zoetangprometheus-dotcom/cyber-turtle-clawhunt/archive/project-documents/GitHub协作交接-2026-10-31.md

# GitHub 协作交接

- 日期：2026-10-31
- 公开仓库：https://github.com/zoetangprometheus-dotcom/cyber-turtle-clawhunt
- 默认分支：main
- 首次提交：66b36433514e1e6f92406a8c0f54c0e03428513d
- 本地工作副本：本目录下 `cyber-turtle-clawhunt/`
- 后端入口：`cyber-turtle-clawhunt/docs/BACKEND_AGENT.md`
- 协作规范：`cyber-turtle-clawhunt/AGENTS.md`
- 提示词：`cyber-turtle-clawhunt/docs/AI_CONTENT.md`

## 后续维护

后续代码、接口和内容修改以 `cyber-turtle-clawhunt/` 为共享代码源，创建分支并通过 PR 合并。原 `A-前端与内容/整体框架-v0.1/` 保留为发布前的本地阶段稿，不与共享仓库自动双向同步。旧项目规划材料仍留在原目录，本次未整体公开 Obsidian 项目资料。

仓库的内容源为 data/content-examples.json 和 data/hexagrams.json；运行 scripts/refresh-demo-data.py 同步 h5/data.js。模型文字 schema 位于 schemas/ai-output-schemas.json。前端代码、样式、交互保持原版本。

用户自行邀请队友；本次未邀请、未授予他人写权限，未配置分支保护，未公开部署网站。GitHub 公开代码与网站上线是不同状态。原创代码许可证尚未选定，第三方 CC0 数据保留来源、许可与校验快照。

## 验收结果

- node tests/history.test.cjs：通过。
- python3 tests/check-data.py：通过；仅结构校验，文化审核尚未完成。
- node --check h5/app.js 与 h5/history.js：通过。
- 数据重新生成后与原 h5/data.js 逐字节一致。
- 内容样例字段、长度和非空规则检查通过，上游原始快照 SHA-256 一致。
- 待发布文件的常见凭据格式与本机私人路径扫描未命中；未上传用户历史记录、密钥或整个 Vault。
- 匿名 GitHub API 和 raw 文件读取成功，确认 PUBLIC、main 及首个提交；24 个远端 blob 与本地内容一致，本地工作区干净。

真实 AI、QR 领取、服务器会话、热敏设备与真实手机浏览器仍待 B 联调，详见后端 README。
