zoetangprometheus-dotcom/cyber-turtle-clawhunt/archive/project-documents/赛博龟壳_产品定位_PRD_三人分工_v3.1.md

# 赛博龟壳 Cyber Turtle｜产品定位、PRD 与三人分工

> **版本**：v3.1（讨论稿）  
> **日期**：2026-10-30  
> **用途**：黑客松商业化产品赛道；供三人团队统一产品定义、界定开发范围、对齐交付接口。  
> **状态**：本文为拟议产品规范，非已实现功能说明。具体芯片型号、屏幕尺寸、打印机、成本、比赛时长及效果指标仍需实测确认。  
> **资料基础**：《赛博龟壳｜黑客松项目规划 v1.0》及后续产品讨论。以本版用户确认的决策覆盖旧版的出生信息、八字排盘、NFC 前置绑定、纸条二维码和摇前主题选择流程。

---

## 0. 一页概要（Executive Summary）

**一句话定位**：一款以东方八卦与六十四卦文化为灵感、采用 ESP32 驱动的手持式桌面互动占卜潮玩，通过摇动起卦、龟甲纹路依次点亮、AI 趣味解读及实体签文打印，创造类似塔罗但具有东方器物美学的仪式体验；用户可在打印结束后扫码获得进一步的主题化 AI 深度解读、数字收藏和分享。

**英文版本**：*An AI-powered physical divination collectible inspired by the I Ching—shake to reveal a hexagram, receive a printed fortune, and optionally scan for a deeper reading and digital keepsake.*

**产品主张**：**遇事不决，摇壳问问。** / *A little fortune, made tangible.*

**必须守住的体验原则**：
1. **不强制手机**：摇动、亮卦、基础解读、打印必须独立完成。
2. **先实体，后数字**：先出签；感兴趣的用户才扫描设备屏幕上的动态二维码，选择主题并获得一次新的、基于原卦的深度解读。
3. **一卦一记录**：纸质基础签与后续电子深度解读属于同一个卦象记录；深度解读不重新起卦。
4. **八卦作可视语言，六十四卦作内容基础**：先后点亮上卦和下卦，纸张上印完整六爻本卦。
5. **古典东方器物优先**：关机/待机时应像可收藏的古典器物，而非通用电子小玩具；光效、屏幕和出纸口服从整体器物语言。
6. **可解释但不神化**：卦象由规则化随机机制确定，AI 做文学化、娱乐化解读，不承诺预测准确性，也不替用户作医疗、投资等重大决定。

**本轮关键变更**：

| 原方案/之前讨论 | 本版确定方向 |
|---|---|
| 首次填写出生年月日 / 八字计算 | **取消**。无个人资料输入；采用八卦视觉和六十四卦内容体系 |
| 手机在起卦前选主题 | **取消前置选题**。默认实体今日签；扫码后才选主题并触发**二次 AI 深度解读** |
| NFC 碰设备再收藏 | **取消作为本版默认路径**；改为 ESP32 中央小屏显示动态二维码 |
| 在签文纸条上印二维码 | **不印**；二维码**仅显示在设备屏幕上**，并在打印完成后出现 |
| 八卦一次性亮起 | **先后点亮上卦、下卦**；最终在纸条呈现完整六爻卦象 |
| 现代赛博玩具外观 | **偏古典东方器物**，以灯光和隐藏式显示实现“古典外观 × 数字内核” |
| 原规划五个技术模块分工 | **三人主责**：①前端/平面/内容生成体验，②硬件/嵌入式/后端，③实体外壳/工业设计 |

---

## 1. 产品定位与市场假设

### 1.1 类别与用户价值

- **品类**：东方文化启发的互动占卜潮玩（Interactive Divination Collectible / Physical Ritual Toy）。
- **体验对标**：塔罗的象征解读、随机惊喜、自我探索与社交话题；**不是**传统塔罗牌的电子替代，也不是以预测准确率作为卖点的算命服务。
- **核心体验**：摇动器物 → 看见卦象显现 → 得到一张真实纸签 → 可选择进一步解读及数字保存。
- **价值主张**：仪式感、惊喜、趣味自我探索、可触摸的纪念以及礼物属性。
- **核心购买场景**：个人桌面收藏与日常趣味使用；创意礼品与朋友/情侣赠礼。**两者暂不排序，首轮测试比较。**

### 1.2 目标用户（待市场验证的细分定义）

| 细分 | 典型特征 | 核心动机 | 验证重点 |
|---|---|---|---|
| A. 轻玄学与自我探索爱好者（主要使用人群） | 建议首批测试 18–30 岁，关注塔罗、星座、易经或情绪仪式，不一定相信其预测能力 | 想获得独特的解读、未知感和心理仪式 | 相比免费 App 是否更愿意使用或购买实体设备 |
| B. 设计潮玩/东方美学收藏者 | 喜欢器物美学、桌面摆件、创意电子产品 | 造型、触感、收藏性 | 不使用功能时是否仍愿意摆放和购买 |
| C. 赠礼购买者 | 给伴侣、朋友或同事挑选新奇礼物 | 赠礼寓意、开箱体验、现场互动 | 送礼意愿、价格带、包装重视度 |
| D. 关系互动用户（未来） | 情侣与朋友 | 双人关系趣味解读和社交破冰 | 是否愿意为了双龟功能购买第二台 |

> 年龄、价格与购买意愿均为**研究假设**，不要在商业 Pitch 中写成已证实的市场事实。

### 1.3 商业逻辑（假设，非收入承诺）

- **首要收入**：B2C 实体设备销售，强调器物外观、娱乐价值及赠礼属性。
- **后续可选**：限定外观/节日礼盒、主题卡面或扩展内容、B2B 活动定制；不建议首版将基础扫码保存强行收费。
- **商业验证**：个人自用与赠礼用户分别询价；收集有价格提示的购买意向，优先考察真实预订/定金等行为，而非仅询问“喜不喜欢”。
- **潜在壁垒**：品牌视觉、器物设计、稳定的完整仪式、内容品质与用户体验；**不把通用 AI API、普通 ESP32 连接或热敏打印称为专利级技术创新**。

---

## 2. PRD：用户旅程与需求

### 2.1 用户场景

**场景 A｜无需手机的默认今日签**
1. 设备处于待机，中央小屏展示品牌 Logo；表面八卦纹路不常亮或仅有很弱的待机灯。
2. 用户拿起龟壳摇动，设备通过运动传感器识别有效动作并防抖去重。
3. 设备先后展示**上卦、下卦**的灯光序列；其组合对应一个**六十四卦本卦**。
4. 云端/后端以固定卦象含义为基础生成**简短基础今日签**，检查结构、长度和安全性。
5. 等待设备稳定后打印纸质签文，纸上有**完整六爻卦形**、卦名、趣味解读和一句小行动；**纸条无二维码**。
6. **打印完成**后，中央小屏由流程状态切换到**本次专属动态二维码**，出现扫码提示及倒计时。
7. 用户可以无视二维码，直接取签结束；到时自动回到 Logo 待机。

**场景 B｜扫码后选择主题并得到深度解读**
1. 在打印完成后的有效时间内，用户扫描设备小屏的动态二维码，打开移动端 H5（无需安装 App）。
2. H5 先展示本次的**固定卦象和基础签文**，让用户确认与纸条对应。
3. 用户可选择**今日/自我、感情、事业/学业、友情**等主题；可直接选择“保存基础签文”，不被迫使用 AI 深度解读。
4. 选定主题后点击“深入解读”，后端基于**同一卦象**、原基础签文、所选主题，进行**第二次 AI 生成**。不重新随机起卦，不覆盖原纸签文字。
5. 页面呈现结构化的扩展解读（例如「卦象含义」「对当前主题的启发」「一个可尝试的小行动」）。
6. 用户可保存为图片或使用系统分享；历史收藏、账号云同步可延后。

**场景 C｜未扫码或二维码过期**
- 不影响已经完成的实体占卜及纸签。
- 过期二维码显示“本次扫码已结束”，再切回 Logo。
- 为避免错配，下次起卦后生成**新的**二维码；过期链接不能自动跳转到“上一位用户的最近签文”。

### 2.2 二维码时效：明确建议

**默认建议：二维码在屏幕上显示 180 秒（3 分钟），且扫码访问令牌在生成后 180 秒过期。**

这是初版产品的**设计建议**，不是平台技术硬性限制。理由：在出纸、拿手机、解锁、启动相机和完成扫描之间留有实际操作余量；同时缩短旁观者在公共/共享设备环境中扫描他人结果的窗口。**建议通过 5–10 人的真实扫码测试再校正为 120–300 秒。**

- **起计点**：以后端确认生成了签文记录、设备反馈打印成功（或以传感器/固件可确认的“打印任务结束”代替）后开始。不能把“命令已发送”冒充“纸张已成功输出”。
- **屏幕显示**：二维码 + “扫码查看/收藏” + 简易剩余时间（如 `02:59`）。到时回 Logo。
- **服务端校验**：短时、高熵、不可预测的随机访问令牌；服务端验证到期时间、记录 ID 和状态；不要只在客户端做倒计时。
- **成功扫码后**：在 180 秒内完成**首次打开页面**即可将会话转成独立的网页会话（建议有效 30 分钟，供选择主题和生成解读）；避免用户刚打开页面、读到一半就失效。网页会话时长也属建议值，可调整。二维码本身仍到期失效。
- **重复扫码**：过期前允许同一 URL 多次打开基础内容；若要限定只有本人可进一步操作，需加入一次性领取或会话占用机制。比赛版建议**首个成功领取的浏览器获得 30 分钟编辑会话**，其他访问者只显示“本次签文已领取/已过期”，避免他人选择主题或拿走分享权限。需要允许合法用户刷新页面（靠短时会话 Cookie/安全令牌实现），而不是每次刷新都重新认领。
- **扫码不及**：本次版本不强制提供“重开上一次二维码”按钮，避免共享设备上误公开上一人内容。以后如加恢复入口，必须设计物理确认及新的短时令牌，且只对当前记录有效。
- **已保存内容**：二维码时效**不等于**收藏时效；用户已打开并保存的图片可长期留在手机，云端留存时长另行约定。
- **下一人摇动**：若上次二维码还在屏上，新一次有效起卦应先终止上一二维码展示并撤销**未领取的**入口，避免扫码读到别人的内容；已领取的网页会话保留自己的签文记录，不被新一签覆盖。

**二维码内容**：短域名下的 HTTPS 链接 + 随机短期访问令牌，例如 `https://<domain>/r/<opaque-token>`（占位格式，非真实可用网址）。二维码编码的是**短 URL**，不直接写明签文、私人提问、连续编号或密钥。

**与 ESP32 屏幕有关的技术条件**：屏幕**具体尺寸/分辨率、显示技术、可视角度、亮度**尚未确认；应实测相机可读性。短 URL、适当二维码版本、足够的像素块宽与白边，比复杂装饰更重要。待机 Logo 可精致，但二维码显示需高对比、无动画遮挡。

### 2.3 占卜生成规则与 AI 边界

- **卦象计算**：两个三爻卦依次选择，上卦与下卦映射为一个确定的六爻本卦（共 64 种）。为每卦建立：上下卦、六爻表示、卦名、解释关键词、固定基础含义。**不要用 AI 直接编造卦名或爻序**。
- **点亮**：一次摇动触发两段灯光。先点亮上卦位置/序列，熄减后再点亮下卦位置/序列；最后纸张上以六条线完整展现本卦。表面八卦排列采用什么传统方位/排列规则，需产品/视觉共同确认；不能任意混用先天与后天八卦的符号布局。
- **随机性**：当前为娱乐随机抽取，不声称测量命运；决定卦象的规则透明可复现，保留测试随机种子/调试模式但不向普通用户显示。
- **基础签文生成 #1**：输入卦象规范数据和默认“今日签”语境；输出短标题、一段趣味提示、一条小行动；经结构校验后固定写入记录。
- **深度解读生成 #2**：用户扫码后自行选主题，才发起第二次 AI 调用；输入**同一卦象 + 所选主题 + 基础签文**，输出结构化内容；不改变本卦及已打印的内容。
- **主题选项**：今日/自我、感情、事业/学业、友情。个性化自由输入不是本版必需；如后续开放文本提问，增加隐私、敏感内容与提示注入防护。
- **内容调性**：温暖、幽默、带适度神秘感，但不全是正能量套话；允许中性提醒，不使用“必然/注定/百分百”等绝对预测。
- **安全性**：娱乐与自我探索，不提供诊断、财富保证、危机处理替代建议，避免对现实重大决定作命令式判断。

### 2.4 功能需求（FR）

| ID | 功能 | 要求/验收口径 | 优先级 |
|---|---|---|---|
| FR-01 | Logo 待机 | 上电显示 Logo；无求签时稳定显示；亮度可调 | P0 |
| FR-02 | 摇动触发 | 正常拿取不易误触发；一次有效摇动只创建一个任务 | P0 |
| FR-03 | 六十四卦规则 | 上下卦组合、卦名与六爻图样一一对应，测试覆盖 64 组合 | P0 |
| FR-04 | 分阶段光效 | 先上卦后下卦，灯光表达与实际本卦一致 | P0（简化光效也需真实） |
| FR-05 | AI 基础签文 | 合规、结构化、可打印、长度受控；断网处理有路径 | P0 |
| FR-06 | 热敏打印 | 真正打印且包含完整卦符；不含二维码；不乱码不截断 | P0 |
| FR-07 | 动态二维码 | 仅在**打印完成后**的小屏显示本次二维码；默认 180 秒 | P0 |
| FR-08 | H5 基础详情 | 扫码看到与纸条对应的卦象/基础签文，不能错配 | P0 |
| FR-09 | 扫码后选主题 | 不需要摇前网页；在数字页选择主题并主动触发深度解读 | P0 |
| FR-10 | AI 深度解读 | 基于同一卦象+选定主题进行第二次生成；状态与失败可恢复 | P0 |
| FR-11 | 保存与分享 | 至少支持保存图片或复制分享内容，明确操作反馈 | P0 |
| FR-12 | 错误/超时 | 网络断开、模型超时、缺纸、二维码到期有明确反馈 | P0 |
| FR-13 | 历史收藏册 | 多日历史、云同步、账户体系 | P2 |
| FR-14 | 双龟社交 | 碰一碰 → 双人关系趣味解读；需独立通信与隐私设计 | Future |
| FR-15 | NFC 扫描 | 本版不作为必需功能，保留未来可能性 | Future |

> 如果比赛时间非常紧，优先保证 **FR-01～FR-08** 的端到端真机演示；FR-09～FR-11 至少制作一条可真实调用的网页路径，不可把静态假界面冒充已实现 AI 深度解读。

### 2.5 非功能需求（NFR）与建议验收

| 项目 | 建议目标（须实测） |
|---|---|
| 稳定性 | 至少 10 次连续完整求签，记录成功/失败、耗时和失败原因 |
| 可理解性 | 至少 5 名陌生测试者不经详细解释，能够摇出签；其中多数能理解扫码是可选的 |
| 扫码成功率 | 不同手机在常见室内光照下实测，建议至少 9/10 次一次扫描成功 |
| 打印 | 中文清晰，六爻图样准确；无严重歪斜、乱码或切纸异常 |
| 隐私 | 不收集出生信息；二维码 URL 不包含用户明文数据；服务端日志不记录完整敏感提问 |
| 安全 | 设备可握持、无明显烫手/锐角/裸露导线；打印时停止摇动检测，保护机构 |
| 电源 | 保证打印机峰值功率；避免灯光、屏幕与打印同时工作导致掉电重启 |
| 性能 | 记录从停止摇动到打印完成的 P50/P90 时间；暂不虚构指标，在测得后填入 Pitch |
| 容错 | 模型调用/打印失败不产生重复打印；任务有唯一 ID 和可重试状态 |

### 2.6 设备状态机

```text
POWER_ON → IDLE_LOGO
IDLE_LOGO --有效摇动--> SHAKE_DETECTED → HEXAGRAM_REVEAL_TOP → HEXAGRAM_REVEAL_BOTTOM
→ AI_BASE_GENERATING → PRINTING → PRINT_FINISHED → QR_ACTIVE (180s) → IDLE_LOGO

AI_BASE_GENERATING / PRINTING --失败--> ERROR（显示原因/重试或离线备用）
QR_ACTIVE --扫码领取--> 网页会话开启；设备继续显示至超时或新请求
QR_ACTIVE --新一签开始--> 关闭旧未领取二维码 → 新流程
```

- 原则：**只能确认打印完成后显示二维码**；若采用无状态反馈的打印模组，须在演示时明确完成条件是假设性时序，并增加超时与失败指示，不能虚称已检测到纸张成功输出。
- 建议通过一枚隐藏式物理按钮提供**取消/复位**，不是交互主入口；是否需要重新打印同一张签由硬件可靠性测试后决定。

### 2.7 数据模型与接口契约（建议）

**核心实体**：

```json
{
  "reading_id": "uuid",
  "device_id": "opaque-device-id",
  "created_at": "timestamp",
  "upper_trigram": "canonical-trigram-id",
  "lower_trigram": "canonical-trigram-id",
  "hexagram_id": 1,
  "hexagram_name": "canonical-name",
  "hexagram_lines": [1,1,1,1,1,1],
  "base_reading": {"title":"...", "message":"...", "action":"..."},
  "print_status": "pending|printing|completed|failed",
  "qr_status": "inactive|active|claimed|expired|revoked",
  "qr_expires_at": "timestamp",
  "deep_reading": {"theme":"friendship", "content":null}
}
```

> 上述 `hexagram_lines` 是**数据结构例子**，不代表示例卦序映射已被审核；实际采用明确的上下/自下而上索引规范，并建立全量单元测试。

**推荐接口边界**：

| API / 事件 | 触发方 → 负责方 | 用途 |
|---|---|---|
| `POST /device/readings` | ESP32 → 后端 | 创建唯一求签任务，提交设备 ID、事件 ID 与卦象（或请求服务器确定卦象，二选一并锁定规范） |
| `GET /device/readings/{id}/status` | ESP32 → 后端 | 获得生成状态、打印内容和二维码令牌（可轮询或长连接） |
| `POST /device/readings/{id}/print-complete` | ESP32 → 后端 | 上报打印任务完成，才启动 QR 时效 |
| `GET /r/{token}` | 用户浏览器 → 后端/H5 | 验证短时令牌并领取页面会话，显示原始签文 |
| `POST /readings/{id}/deep-reading` | H5 → 后端 | 提交主题，触发第二次 AI 解读；权限由会话验证 |
| `GET /readings/{id}/deep-reading` | H5 → 后端 | 查询生成状态与结果 |
| `GET /readings/{id}/share` / 客户端导出 | H5 → 前端/后端 | 生成可保存图片或分享内容 |

**API 协议原则**：
- 设备认证密钥与模型 API Key **只在后端安全存储**，不写入网页代码或公开仓库。
- 每次摇动拥有唯一事件 ID，实现幂等性，重试不重复生成或打印。
- 后端保存卦象与基础签文的不可变快照；深度解读只增加附属记录。
- 设备二维码链接与用户 Web 会话应独立，不把一次性扫码 token 永久当用户身份凭据。
- 原型开发如为减少范围使用简化身份体系，也需标记为 Demo，不以其安全性满足商业量产要求。

---

## 3. 视觉与工业设计规范

### 3.1 外观定位：古典东方器物

**方向关键词**：龟甲、卜筮器、温润、含蓄、克制、留白、光从纹路中浮现。

- 休眠时是一件值得摆放的器物：隐藏 LED 和屏幕的数码感，不以炫光/赛博朋克为主。
- 外形首先满足**握持摇动的平衡、重量、表面触感**，其次再追求龟壳形体精致度。
- **屏幕位于产品中央**，待机显示 Logo；打印后展示扫码二维码。应将它视为器物的“印记/铭牌/核心窗口”，而非突兀手机小屏。
- 八卦纹路既是视觉主题，也是起卦光效的真实反馈层。可尝试半透光壳体、内嵌导光结构、扩散片。
- 以古铜、陶、玉石感、木质调等作为**材质语言参考**，原型可以采用可加工的塑料/树脂表面处理，不能误称实物为玉或古董材料。
- 确定纸张出口：可以从嘴部或尾部，但优先保证纸路平直、换纸容易和用户抽纸安全，不为“戏剧性吐纸”牺牲可靠性。
- **纸面不印二维码**：把空间留给卦符、卦名、签文和品牌标识。

### 3.2 屏幕信息规范

| 设备状态 | 中央屏显示 |
|---|---|
| 待机 | 品牌 Logo（静态或低功耗微动效） |
| 识别摇动 | 极简起卦反馈，例如脉冲符号 |
| 上/下卦显现 | 可显示“上卦 / 下卦”或对应卦符；具体可与灯效共用语言 |
| 正在解读 | 极简加载图形/“解签中” |
| 正在打印 | “出签中”或进度符号 |
| 打印完成 | 本次**唯一动态二维码** + 扫码提示 + 180 秒倒计时 |
| 超时 | 返回 Logo；必要时短暂显示“已结束” |
| 异常 | 简短可理解的错误图标/说明（缺纸、断网、生成失败） |

### 3.3 纸签信息层级

1. 品牌标识/今日签；
2. **完整六爻卦形**（六条阴阳线，约定自下而上读取的渲染规则）；
3. 卦名及上卦、下卦标签；
4. AI 基础签标题和简短解读；
5. 今日小行动 / 简短彩蛋。

纸面须优先保证中文清晰、尺寸适配和版式美观，避免过密文字；**绝不包含二维码**。纸张褪色问题由扫描设备屏幕进入的数字保存链路缓解，而非宣称热敏纸不会褪色。

---

## 4. 三人分工与责任边界

### 4.1 对原拟分工的审查结论

原拟方案基本合理，**但“前端包括生成部分”和“硬件（后端）部分”存在责任歧义**。建议将生成工作分成：
- **前端/内容负责人**：**决定生成什么**——卦象内容字典、提示词、签文格式、内容体验、数字页和图片/分享设计；也负责签文的平面设计。
- **硬件/后端负责人**：**决定如何安全稳定地生成**——ESP32 固件、摇动识别、屏幕、灯光、打印、云端 API、模型密钥、两次模型调用执行、数据库/记录、二维码令牌、会话时效与部署。
- **实体外壳负责人**：**决定它作为器物如何握持、装配和被看见**——外观、结构、透光、开孔、换纸、散热、电源空间、样机、测试与工艺。

**跨团队最终产品决策**由三人共同确认；建议指定一名兼任产品协调人，负责冻结 PRD、裁决接口变更和汇总 Pitch，不新增第四名岗位。

### 4.2 WBS：负责人 A｜前端、签文平面与 AI 内容体验

| 编号 | 子任务 | 具体交付 | 依赖/验收 |
|---|---|---|---|
| A01 | 信息架构及用户路径 | 扫码落地页 → 基础签文 → 主题选择 → 深度解读 → 保存/分享流程图 | 与 B 的 token/会话状态一致 |
| A02 | 视觉体系与品牌规范 | Logo 在屏幕、纸签、H5 中的规范；字体、色彩、符号系统 | 适配东方器物语言，与 C 协同 |
| A03 | 64 卦内容字典 | 卦名、上下卦、六爻编码、关键词、文化解读来源/核对表 | 与 B 统一 ID、索引与阴阳线规则；64/64 核对 |
| A04 | 基础签文文案结构 | 标题、基础解读、小行动、字数/换行规范与例子 | B 返回结构稳定；纸签布局不溢出 |
| A05 | AI 深度解读规则/提示词 | 4 类主题 prompt、结构化输出 schema、风格与安全规则 | 需交 B 以服务端执行；同一卦象不变 |
| A06 | 内容质量测试 | 重复度、幻觉卦名、不当决定建议、缺字段与超长处理用例 | 覆盖至少 64 卦映射与常见主题样例 |
| A07 | 纸签平面设计 | 真实纸宽版式、六爻卦符、图文层级、中英文/品牌元素 | 与 B 打印机接口和 C 出纸尺寸一致；无二维码 |
| A08 | H5 页面设计 | 移动端响应式稿、组件状态（加载、到期、认领失败、AI 出错） | 主流手机可用，界面易读 |
| A09 | H5 前端实现 | 动态路由、基础签文详情、主题选择、深度解读加载及结果展示 | 实际调用 B 的后端 API，不在浏览器暴露 Key |
| A10 | 分享与保存 | 生成社交分享卡、图片导出或系统分享/复制回退 | 本地保存可用，品牌与来源清晰 |
| A11 | H5 联调/QA | token 过期、重复刷新、主题选择、生成异常、分享测试 | 与 B 形成端到端验收记录 |
| A12 | Pitch 视觉内容 | 用户故事、产品亮点、商业模型与前后端体验 UI 演示素材 | 与三人共同维护事实/假设标签 |

**A 的边界**：负责 prompt 和生成内容的产品逻辑，**不单独负责服务端模型密钥/部署/数据库**。签纸视觉稿由 A 负责，打印驱动由 B 负责。

### 4.3 WBS：负责人 B｜ESP32、固件、联网、后端与模型执行

| 编号 | 子任务 | 具体交付 | 依赖/验收 |
|---|---|---|---|
| B01 | 硬件选型/BOM | ESP32 具体型号、显示屏尺寸与接口、IMU、LED、打印机、电源、连接件清单 | 与 C 共定安装尺寸；验证预算与供电峰值 |
| B02 | ESP32 基础固件 | 启动、任务调度、存储、日志及设备 ID | 可稳定启动与复位 |
| B03 | 摇动识别/去重 | IMU 阈值、有效摇动结束判定、重复触发锁定 | 日常拿取不误触发，单摇单任务 |
| B04 | 64 卦生成/映射 | 统一选择上下卦并映射为本卦；测试输出卦符 | 与 A 的 64 卦字典完全一致 |
| B05 | 灯光控制 | 上卦→下卦时序；与屏幕、打印状态同步 | 实物显示与生成卦象一致，与 C 光路匹配 |
| B06 | 中央屏 UI | Logo 待机、等待/打印状态、二维码与倒计时、错误反馈 | 真机二维码可扫；与 A 的视觉体系一致 |
| B07 | 打印驱动 | 中文点阵/位图打印、六爻渲染、排版数据映射、纸仓异常处理 | 真纸签清晰，无 QR，打印完成有可核实条件 |
| B08 | 电源/通信可靠性 | Wi-Fi 连通、打印峰值电流、断线重连、基本保护 | 打印时不掉电；可恢复网络故障 |
| B09 | 后端记录和状态机 | reading_id、基础内容快照、打印状态、QR 状态、深度解读记录 | 幂等、状态可查询、不会错配 |
| B10 | 两阶段 AI 服务 | 基础签调用与扫码后主题解读调用；结构化校验/重试/缓存 | 使用 A 提供的 prompt/schema；API Key 仅后端 |
| B11 | 动态二维码令牌 | 每签高熵 token、生成/撤销/到期；ESP32 返回短 URL 显示 QR | 默认 180 秒，服务端真正校验，过期无泄露 |
| B12 | H5 会话/权限 | 首次访问领取、30 分钟网页会话、刷新恢复、多人竞争行为 | A 页面能正确处理已领取/过期/失效状态 |
| B13 | 云服务部署与配置 | HTTPS 域名、环境变量、部署说明、日志与基本限流 | 公共场景手机能访问，服务重启数据有明确策略 |
| B14 | 备用与恢复 | AI 超时、离线简版签文、缺纸、网络重试、错误提示 | 出错不重复打印；告知是否真实 AI 输出 |
| B15 | 端到端联调/稳定性 | 连续完整演示记录、不同手机二维码扫码实测 | 与 A/C 三方共同签收 |

**B 的边界**：负责真正执行两阶段 AI 生成与所有敏感的服务端业务逻辑；A 定义生成内容、网页和视觉。硬件电子部分归 B，实体壳体/装配结构归 C。

### 4.4 WBS：负责人 C｜实体外壳、结构与工业设计

| 编号 | 子任务 | 具体交付 | 依赖/验收 |
|---|---|---|---|
| C01 | 古典东方器物概念 | 造型语言板、材料/表面处理方向、草图多方案 | 产品必须可手持摇动，外观能独立成为桌面器物 |
| C02 | 人机与尺寸研究 | 重心、握持位置、摇动动作、屏幕视角、持握防滑 | 与 B 模组真实重量、尺寸相符 |
| C03 | 八卦图案系统 | 表面纹路造型、布局、与上/下卦灯光匹配的区域 | 与 A 的卦符系统和 B 灯效一致 |
| C04 | 中央屏整合 | 屏幕窗口/镶嵌/遮光/防刮，Logo 与 QR 视觉位置 | 能扫二维码；不得被曲面边缘/纹理遮挡 |
| C05 | 出纸/纸仓结构 | 打印模块固定、出纸路径、取纸、换卷与检修方案 | 真实不卡纸、取纸方便、纸条无 QR |
| C06 | 电控内部布局 | ESP32、电池/电源、IMU、LED、线束、固定/减震结构 | 与 B 共同装配；摇动不松脱 |
| C07 | 透光与灯效打样 | 扩散、遮光、纹路均匀性、上下卦区分方式 | 实体可辨识两段点亮，没有明显串光 |
| C08 | CAD 建模与工程输出 | 三维模型、分件、装配、紧固/卡扣方案、关键尺寸 | 能打印/加工并可重复拆装 |
| C09 | 原型制作与装配 | 3D 打印/手板、表面处理、整机装配 | 完成真实可握持样机，不仅渲染图 |
| C10 | 外观与可靠性迭代 | 重心优化、边缘安全、纸仓、散热/供电口、维护性 | 摇动与打印均稳定；屏幕和纹路可读 |
| C11 | 展示与商业化素材 | 产品渲染、场景图、包装概念、器物细节图 | 不把未实现渲染与可运行真机混淆 |

**C 的边界**：不单独负责固件、电路及扫码页面；但必须从第一天与 B 协同核对屏幕、打印机、纸仓与供电模组的真实尺寸。**先定内部硬件包络，再冻结外观结构。**

### 4.5 横向依赖与接口清单

| 横向事项 | 主责 | 配合 | 冻结/验收点 |
|---|---|---|---|
| 64 卦数据表、六爻方向 | A | B、C | 同一 canonical ID 与准确纸面呈现 |
| Logo/卦象/纸签的视觉一致性 | A | C、B | 屏幕、纸签、H5 看起来像同一品牌 |
| ESP32 屏幕规格及 QR 可扫性 | B | C、A | 真机扫码成功后才能锁定窗口造型 |
| 打印宽度、纸卷/出纸结构 | B | A、C | 纸签布局与机械纸路相容 |
| AI 内容 schema 与执行 | A（规则）/ B（调用） | 双方 | 同一字段、长度上限、错误策略 |
| QR token 领取及网页页面状态 | B（协议）/ A（呈现） | 双方 | 180 秒时效、30 分钟会话与已领取逻辑一致 |
| 演示端到端链路 | B（整机） | A、C | 真实摇动→灯光→打印→设备屏 QR→网页主题深解→保存 |
| 商业定位与 Pitch | 三人共同 | 建议 A 整合 | 标注哪些已实现、哪些假设、哪些未来愿景 |

### 4.6 建议的阶段顺序（不是详细排期）

1. **冻结产品契约**：确定芯片/屏幕/打印模组的实物参数、64 卦字典、签文 schema、QR 生命周期与 API。
2. **并行验证最关键单点**：B 跑通 ESP32 屏幕 QR、中文打印和摇动触发；A 输出签文纸面/H5/内容样例；C 先做尺寸与内部布局。
3. **完成设备主链路**：摇动→上下卦灯效→基础签文→真打印→屏显二维码。
4. **接入数字深度体验**：扫码领取→选主题→第二次 AI 深解→导出分享。
5. **整机打样与测试**：结构装配、真实扫码距离、连续摇动、打印和异常情况。
6. **形成商业 Pitch**：可运行真机 + 过程视频 + 用户测试记录 + 成本/定价假设 + Future Vision。

---

## 5. 商业 Pitch 框架（供团队后续展开）

1. **Hook**：生活中的小纠结，并不总需要标准答案；人们也想获得仪式感和惊喜。
2. **Problem**：数字占卜/AI 聊天易用却缺少真实触摸、留存与赠礼体验。
3. **Solution / Demo**：现场摇壳，上卦/下卦灯光出现，出纸；打印后中央屏亮出 QR，扫码展开主题化二次解读并保存分享。
4. **Why Different**：东方六十四卦内容框架、古典器物美学、可视化仪式、真实纸签、数字深度解读形成闭环。
5. **Target Customers**：轻玄学/自我探索者、东方审美与潮玩收藏者；对比个人使用与赠礼购买意愿。
6. **Business Model**：B2C 硬件为主、后续定制/限定系列；不虚构销量、毛利率及订单。
7. **Evidence & Roadmap**：真机成功率、用户反馈、初步 BOM 与定价测试；未来双龟碰一碰的恋爱/朋友关系趣味解读。

**三大差异化的讲法**：
- **Physical Ritual**：摇动和分阶段卦象灯光。
- **AI Interpretation**：基础今日签 + 扫码后按主题二次深度解读。
- **Tangible & Digital Keepsake**：出签 + 设备屏动态 QR + 数字保存与分享。

**未来设想**（非本轮承诺）：两台龟壳触碰/近场配对，生成恋爱、友情、双人合盘式**娱乐**解读。仅静态 NFC 标签不足以实现两设备双向连接；未来须专门设计配对通信方案。

---

## 6. 验收用例与边界情况

| 编号 | 用例 | 预期结果 |
|---|---|---|
| T01 | 待机不操作 | 屏幕稳定显示 Logo，无自动生成 |
| T02 | 轻轻移动/拿取设备 | 不误触发 |
| T03 | 有效摇动一次 | 上卦后下卦，进入一次生成与打印，不重复 |
| T04 | 卦象与纸签一致 | 上/下卦、六爻形状、卦名来自同一个本卦记录 |
| T05 | 打印结束 | 屏幕才出现本次唯一 QR，纸面没有 QR |
| T06 | 打印后 120 秒扫码 | 打开本次纸签对应页面，可选择主题 |
| T07 | 打印后超过 180 秒首次扫码 | 入口过期，不显示他人的结果 |
| T08 | 175 秒扫码成功后再停留 5 分钟 | 领取的页面会话仍能完成二次解读（若会话未超过 30 分钟） |
| T09 | 更换主题后生成 | 保持原卦和基础签不变，仅添加对应主题深解 |
| T10 | 保存/分享 | 生成视觉清晰的电子卡片，用户可存到手机或分享 |
| T11 | 两个人抢扫同一 QR | 仅允许一个领取深解会话，其他请求提示已领取或不可操作 |
| T12 | 前一签 QR 尚未过期又开始新一签 | 旧的未领取入口撤销；新签产生新 token；已领取页面不串签 |
| T13 | 断网/AI 超时 | 明确提示，按设计使用离线备用或可恢复重试，不虚称实时 AI |
| T14 | 纸张/打印失败 | 不显示“打印成功”的二维码；可从同一签文记录恢复而非另起一卦 |
| T15 | 模型输出不当 | 经结构/内容校验，提供可控备用文本，不将高风险指令打印 |

---

## 7. 当前仍待确认、不可擅自假设的事项

1. **ESP32 的具体型号**（例如 ESP32 / ESP32-S3 等）、RAM/Flash、屏幕分辨率、接口与实际 QR 码显示尺寸。
2. **打印模块规格**（58 mm 纸宽是否适用尚未确认）、切刀/纸张状态反馈、峰值电流与字体位图能力。
3. **电源方案**（锂电池、外接 USB 或两用）、可摇动的质量与内部固定方式。
4. **八卦表面排列**：确定符号、上/下卦灯光的同圈复用方式及最终符号渲染规范。
5. **二维码时长**：目前设计建议为**180 秒**；真实测试后可在 **120–300 秒**范围调整。
6. **联网与后端部署**：现场 Wi-Fi、HTTPS 域名、模型 API 成本、日志/数据保存时间和分享链接策略。
7. **打印后显示二维码的“完成”定义**：所选打印硬件是否可以反馈成功；否则至少等待打印动作及机械稳定，并在展示中如实说明检测限制。
8. **产品尺寸/预算/比赛剩余时间**：只有这些被确定后才能准确分配 P0/P1 与排期。
9. **定价/成本/购买意向**：须收集供应商报价和用户付费验证，不应填入臆测的市场数据。
10. **AI 文化内容准确性**：64 卦卦名、上下卦、爻线与解释需要有可核对来源；不要把创作文案误标为古籍原句。

---

## 附录 A｜关键决策摘要

- ✅ 不收集出生年月日；不做八字排盘。
- ✅ **八卦视觉 + 六十四卦内容**，**一次摇动、上卦先亮、下卦后亮、纸上完整六爻**。
- ✅ **先打印基础今日签；后扫屏幕二维码、选主题、二次 AI 深解、保存分享**。
- ✅ **纸张上不放二维码**；动态二维码仅显示在 ESP32 的中央小屏，待机为 Logo。
- ✅ **二维码默认有效 180 秒**（已领取的网页会话建议 30 分钟；需实测）。
- ✅ **古典东方器物**，以手持摇动的桌面潮玩为实体形态。
- ✅ 自用与赠礼两种购买场景并行测试，不提前武断择一。
- ✅ 三人分工：A 前端/平面/内容，B 硬件/后端，C 工业设计/壳体；接口边界写清楚。
- ⏭ 双龟碰一碰、双人解读、NFC、账号历史云收藏为未来方向。

## 附录 B｜参考资料（用于技术方案核对）

- 原始内部资料：《赛博龟壳｜黑客松项目规划 v1.0》（2026-10-30）；本稿根据后续产品反馈更新，以上新设定优先。
- Espressif 官方图形界面相关资料：<https://docs.espressif.com/projects/esp-iot-solution/en/latest/display/lcd/gui_solution.html>，说明 ESP32 显示交互可采用官方适配组件；实际能否流畅显示二维码依赖具体芯片、屏幕与内存。
- RFC 10027，跨设备流程短时二维码/一次性代码的安全建议：<https://www.rfc-editor.org/info/rfc10027/>。**180 秒是本项目自定体验参数，不是 RFC 统一规定的 TTL。**
