zoetangprometheus-dotcom/cyber-turtle-clawhunt/archive/project-documents/A-前端与内容/00-A角色任务与交付总表.md

---
date: 2026-10-31
date-basis: user-request
updated: 2026-10-31
type: project
language: zh-CN
tags: [project, cyber-turtle, role-a]
ai-first: true
status: draft
---
# A 角色任务与交付总表

> 2026-10-31 第二轮更新：用户已确认“古典外观＋温暖现代解读”，纸签缩短、网页扩展，增加同卦问卦输入、本机历史与日历。此项决定覆盖本文早期“不加自由提问/历史留待未来”的范围；实现与接口见 [[整体框架-v0.1/11-第二轮确认与问卦历史规范]]。

## 给后续 Codex
用户已明确自己承担 A 角色，并授权本项目产出保存在项目目录内。本文件依据 [[01Projects/Clawhunt 黑客松 - 赛博龟壳/赛博龟壳_产品定位_PRD_三人分工_v3.1]] 制作；新增细节是 AI 辅助工作稿，未经团队确认或真机验收，不覆盖 v3.1。
任务入口：[[01Projects/Clawhunt 黑客松 - 赛博龟壳/A-前端与内容/00-A角色任务与交付总表]]。截至 2026-10-31，未取得硬件参数、后端或比赛官方要求。

## 你的最终目标
让同一签文在纸签、设备屏与手机上清楚一致地呈现，并让用户顺畅完成「查看基础签 → 可选主题深解 → 保存分享」。A 定义内容与呈现，B 执行模型调用和设备/服务端逻辑，C 实现实体结构。

## 交付任务与完成条件
| 顺序 | 对应 WBS | 交付物 | 何时算完成 | 本次状态 |
|---|---|---|---|---|
| 1 | A01 | 用户流程、页面状态、按钮文案 | 无手机也能结束；扫码后能直接保存或选主题；错误有出口 | 初稿已制作，见 03 |
| 2 | A03 | 64 卦 JSON、来源核对表 | 64 个唯一 ID；上下卦/六爻/名称逐项核对；来源可追溯 | 尚未制作全量字典；字段与审核方法见 01 |
| 3 | A04–A06 | 基础签及深解 prompt、输出 schema、内容样例 | B 能接入；符合长度、主题和同卦约束；完成模型抽样评测 | 初稿与静态样例已制作，未调用模型 |
| 4 | A02 | Logo、字体/色彩/符号规范 | 屏幕、纸签、H5 一致；小尺寸可辨；字体许可清楚 | 视觉 brief 已制作，图形资产待制作 |
| 5 | A07 | 纸签版式、打印位图/模板 | 真实打印宽度下清晰、不截断、六爻正确、无二维码 | 信息层级与文案稿已制作，真尺寸排版待 B 参数 |
| 6 | A08 | H5 设计及组件状态 | 基础/主题/深解/保存及异常完整；手机尺寸可读 | 流程和文案已制作，高保真稿待制作 |
| 7 | A09 | H5 前端 | 接入 B 的真实会话与生成 API；无 Key 暴露、串签或重复提交 | 未实现，依赖接口确认 |
| 8 | A10 | 分享卡与导出 | 手机实际保存成功；取消分享与失败有反馈；无访问令牌泄漏 | 内容规范已制作，设计及实现待完成 |
| 9 | A11 | 联调验收记录 | 领取/刷新/过期/换主题/失败重试/保存均有实测证据 | 用例已制作，未执行 |
| 10 | A12 | Pitch 视觉与演示材料 | 真实演示与愿景区分；市场/成本有依据 | 叙事骨架已制作，证据待补 |

## 现在可以推进与需要配合的工作
- A 可直接推进：选择内容语气、64 卦资料核对、页面草图、Logo 探索、四主题文案。
- B 需提供：打印有效点宽/DPI与中文渲染方式、屏幕像素和窗口尺寸、API 示例及错误码、会话领取方案、模型输出限制。
- C 需提供：器物外观方向、屏幕窗口/出纸口位置与尺寸、表面符号和灯光布局。
- 三人需确认：比赛截止时间、预算、卦象在设备还是后端确定、主题重复生成与缓存策略。

未取得截止时间，采用交付关口推进，不虚构每日排期。

## 建议推进顺序
1. 先共同审阅「一条基础签 + 同卦四主题」样例，确认声音、长度和信息密度。
2. A/B 锁定数据与接口，同时核对 64 卦数据；A/C 对齐器物与数字视觉。
3. 制作真实宽度纸签及 H5 高保真稿，再实现前端和保存功能。
4. 使用真实后端与真机联调，最后根据实测结果制作 Pitch。

## 本文件夹导航
- [[01-内容规范与64卦数据要求]]：文案、字段、文化资料核对。
- [[02-AI提示词与内容样例]]：可交给 B 的 prompt 和可阅读样例。
- [[03-H5流程与界面文案]]：页面、按钮、异常与动效。
- [[04-品牌纸签与分享卡制作说明]]：视觉制作和纸面排版依据。
- [[05-跨角色对接与验收清单]]：参数清单、测试、Pitch、开源参考。
- `06-ai-output-schemas.json`：两阶段模型输出的 JSON Schema 草案。
- `07-content-examples.json`：一条基础签、同卦四主题深解与非实时备用文案。

## 本轮交付记录
本轮完成任务拆解及第一批可评审内容，未制作完整 64 卦库、Logo、高保真 UI、前端或可打印终稿。静态结构检查不能证明模型输出质量、文化准确性、手机保存或硬件效果。
下一步唯一动作：先审阅 02 的基础签与四主题样例，确认内容语气后再扩展全量内容。

## 2026-10-31 整体框架交付更新
用户授权先完成大体框架，未回答的个性化选择按推荐方案推进，后续第二轮修改。此前表格为首批内容稿状态；本段更新当前进展。

- 新入口：[[整体框架-v0.1/README]]；直接用浏览器打开 `整体框架-v0.1/h5/index.html`。
- 已补齐 64 卦候选数据与核对表、H5 交互演示、PNG 导出、纸签预览、状态控制台、接口交接。结构检查通过，文化内容未完成审核。
- 已保留研究原文、授权与哈希清单，未接入真实 AI、扫码授权或硬件。
- 下一轮问题与默认选择：[[整体框架-v0.1/08-推荐选择与第二轮问题]]。
- 实测范围：[[整体框架-v0.1/10-验收与交接]]。
- Logo、文案和 H5 视觉是可修改默认稿；未宣称正式上线。

## 第二轮完成项
本机历史/日历、同卦问卦交互、短纸签与长网页均已制作并做针对性检查；问卦使用明确标注的模板演示，实际 AI 待 B 接入。详见 [[整体框架-v0.1/11-第二轮确认与问卦历史规范]]。

## 纸签比例与前端重点审查
2026-10-31：已放大纸签卦形/卦名/标签，390px 浏览器核对通过。前端剩余接入、数据覆盖、容错和焦点问题见 [[整体框架-v0.1/12-前端剩余工作审查]]；除指定视觉修改外，审查发现尚未修复。

## 三项审查问题修复
2026-10-31：F01 多页历史覆盖、F02 历史局部坏数据、F03 日历焦点丢失均已修复并复验；见 [[整体框架-v0.1/13-三项前端修复验收]]。真实后端和设备接入仍待完成。
