zoetangprometheus-dotcom/cyber-turtle-clawhunt/archive/project-documents/A-前端与内容/04-品牌纸签与分享卡制作说明.md

---
date: 2026-10-31
date-basis: user-request
updated: 2026-10-31
type: project
language: zh-CN
tags: [project, cyber-turtle, role-a]
ai-first: true
status: draft
---
# 品牌、纸签与分享卡制作说明

> 2026-10-31 第二轮更新：用户已确认“古典外观＋温暖现代解读”，纸签缩短、网页扩展，增加同卦问卦输入、本机历史与日历。此项决定覆盖本文早期“不加自由提问/历史留待未来”的范围；实现与接口见 [[整体框架-v0.1/11-第二轮确认与问卦历史规范]]。

## 给后续 Codex
用户已明确自己承担 A 角色，并授权本项目产出保存在项目目录内。本文件依据 [[01Projects/Clawhunt 黑客松 - 赛博龟壳/赛博龟壳_产品定位_PRD_三人分工_v3.1]] 制作；新增细节是 AI 辅助工作稿，未经团队确认或真机验收，不覆盖 v3.1。
任务入口：[[01Projects/Clawhunt 黑客松 - 赛博龟壳/A-前端与内容/00-A角色任务与交付总表]]。截至 2026-10-31，未取得硬件参数、后端或比赛官方要求。

## 视觉方向
沿用 v3.1 的古典东方器物方向。数字页面暂以纸白为主、墨黑为文字、低饱和蓝为交互辅助，朱红仅作少量印记候选；这是工作方向，不是已定稿色板。Logo 尚未制作，不用临时字标冒充最终 Logo。

建议先完成一个清楚的“赛博龟壳 / Cyber Turtle”文字组合，再探索龟甲与卦线的图形关系。避免随意把传统卦符旋转/拼接成错误卦象。各面使用同一卦符绘制规则，图标选用开源 UI 图标，不用 emoji。

## 三种载体的制作要求
| 载体 | 重点 | 交付形式 |
|---|---|---|
| 中央屏 | Logo 小尺寸识别、状态文字、QR 清晰 | B 确认分辨率后输出对应位图与状态稿 |
| 热敏纸 | 单色、中文可读、六条阴阳线准确 | 有效点宽下的单色打印模板与试打样 |
| H5 / 分享卡 | 同一品牌、阅读层级、保存后独立可读 | 响应式稿、导出卡模板 |

屏幕 QR 的短链接编码、白边和像素模块须由 B 真机验证；Logo 和纹理不占用 QR 可读区域。

## 纸签内容稿 v0.1
以下顺序可直接用于排版。卦形必须由数据绘制，以下文字说明不是打印内容：

```text
赛博龟壳
今日签

[完整六爻卦形]
乾
上卦 乾 · 下卦 乾

先走一小步

不必等到万事俱备，先给想做的事一个小小的开头。持续向前，也给自己留一点余力。

今日小行动
花十分钟，开始一件想做的事。

遇事不决，摇壳问问
娱乐与自我探索
```

换行由真实字体和有效点宽计算，不使用上述示意换行作为打印指令。纸条无二维码，不添加扫码 token、用户资料或虚假幸运指数。

## 打印终稿前需要 B 提供
纸卷标称宽度、实际可打印点宽、DPI、左右安全区、中文字体/位图打印方案、最大连续纸长、进纸/切纸能力。不能默认 58 mm 或 384 点；未确认前不提交量产或打印终稿。

如果需要缩短纸签，先减少正文长度和装饰间距，保留完整六爻、名称及核心行动，不通过过小字号硬塞内容。

## 两类分享卡文案结构
基础签卡：品牌 → 卦形和卦名 → 基础标题 → message → 今日小行动 → 娱乐与自我探索。

深解卡：品牌 → 卦形和卦名 → 主题标签 → 深解标题 → 卦象启发 / 对你的启发 / 一个小行动 → 娱乐与自我探索。

不默认把基础签全文与深解全文塞到一张卡；深解卡保留原卦身份即可。导出高度随文本增长，不能裁掉尾部行动或声明。不加二维码，不把会话地址当公开分享链接。

## 待制作资产
Logo 主组合与单色版、八卦符号组件、六爻渲染组件、纸签真实宽度版、H5 状态稿、两种分享卡。字体确定后登记官方来源与授权，再导出资产；当前未下载字体和图标。
