zoetangprometheus-dotcom/cyber-turtle-clawhunt/archive/project-documents/A-前端与内容/整体框架-v0.1/08-推荐选择与第二轮问题.md

---
date: 2026-10-31
date-basis: user-request
updated: 2026-10-31
type: project
language: zh-CN
tags: [project, decisions]
ai-first: true
---
# 推荐选择与第二轮问题

## 给后续 Codex
用户授权未回答时采用推荐方案，以下是执行默认值，不等于用户已经确认个人审美或团队硬件选择。范围为本项目 A 角色整体框架。

| 原本需要询问 | 本轮采用的选择 | 理由 / 后续修改位置 |
|---|---|---|
| 品牌中文名/英文名是否最终确定 | 赛博龟壳 / Cyber Turtle | 沿用 PRD；index.html、导出卡文字 |
| Logo 要图形还是字标 | 暂用排版字标 | 保持可用，不提前冻结个性化图形 |
| H5 视觉偏古典还是科技 | 纸白、墨黑、低饱和蓝；衬线标题 | 与器物方向及默认配色兼容；style.css |
| 文案更幽默还是更神秘 | 温暖、克制、具体，少量神秘感 | 易读且不夸大预测；上级 02/07 |
| 卦名用简体还是繁体 | 数据保留来源繁体，界面其余用简体 | 先保持来源一致；后续做明确映射，不静默改原始文件 |
| 是否加入自由提问 | 暂不加入 | 遵守 v3.1，先保证四主题完整 |
| 主题是否预选 | 不预选 | 明确用户主动选择才触发深解 |
| 同一主题重复生成 | 演示缓存，真实服务建议读取已有成功结果 | 避免无意义重复费用；需 B 确认幂等/计费策略 |
| 未扫码是否有历史找回 | 无 | 防止共享设备暴露前一人的签文；符合本版范围 |
| 保存方式 | PNG + 复制文字回退 | 无需账号；手机相册行为待真机测 |
| 分享卡横版或竖版 | 900 px 宽竖卡，高度随文案增长 | 保持可读且不裁字；app.js |
| 纸张尺寸 | 58 mm 仅试排 | B 尚未提供实际点宽；CSS print-area，不能作为生产规格 |
| 二维码/会话时间 | 保留 180 秒 / 30 分钟提案 | 本演示不执行认证计时；真实服务由 B 验证 |
| 前端技术栈 | 无依赖原生 HTML/CSS/JS | 当前功能小，直接打开方便；接入时再依据 B 的栈调整 |
| 后端暂不可用时怎么办 | 显式静态演示 | 不模拟真实安全认证，不消耗模型费用 |
| H5 页面结构 | 一个详情页加导出弹窗 | 保持基础签→主题→深解连续，不增加账户与首页 |
| 路演长度 | 暂按六段结构，不指定分钟 | 等主办方时长和评审要求，再裁剪 |

## 醒来后优先回答的五项
1. 整体更希望“古典神秘”还是“温暖有趣”？可用当前样例指出喜欢/不喜欢的句子。
2. Logo 是否保持当前名称，有没有必须使用的图形或参考图？
3. 纸签是越短越好，还是希望保留现在这一段文字？
4. H5 现有纸感、留白、蓝色按钮是否保留？
5. 比赛截止时间、演示时长、B/C 已确定的屏幕/打印参数是什么？

这些问题不阻塞当前框架完成；下一轮按回答修改，不将默认值当永久规则。

## 第二轮已明确的决定（覆盖上述默认）
用户已确认古典外观＋温暖现代解读、纸签更短、网页更长；新增同卦自由提问与本机历史日历。原“不加入自由提问/无历史”不再适用。其他视觉维持现状；Logo、字形、二维码时效、硬件/比赛参数仍未确认，不在本轮继续追问。
