zoetangprometheus-dotcom/cyber-turtle-clawhunt/archive/project-documents/A-前端与内容/整体框架-v0.1/10-验收与交接.md

---
date: 2026-10-31
date-basis: user-request
updated: 2026-10-31
type: project
language: zh-CN
tags: [project, acceptance]
ai-first: true
---
# 框架验收与交接

## 给后续 Codex
本记录只描述 2026-10-31 的实际检查。用户要求 A 角色整体框架先完成、个性化内容后修。未发生真实模型、扫码、打印或支付操作。

## 已完成
- 64 卦候选数据导入、授权/原始来源/SHA-256 留存；逐卦文化核对 CSV。
- 无依赖 H5、四主题样例切换、模拟加载/错误/重试、状态预览。
- Canvas PNG 导出预览、下载入口、复制文字回退；纸签试排与浏览器打印入口。
- 设计默认值、第二轮问题、接口对接和接入位置说明。

## 已检查
- `node --check h5/app.js` 通过。
- `python3 tests/check-data.py` 通过：64 个 ID、64 个上下卦组合、64 个不同六爻数组、三爻拼接、泰/否方向锚点。
- 浏览器实际点击“感情→深入解读”，出现对应固定内容，基础签保留。
- 点击保存解读卡，PNG 已生成并加载，读取到 900×1203 像素；预览存在下载与复制入口。
- 模拟生成失败显示重试与原基础签；点击重试后错误区关闭。
- 切换扫码过期状态，页面显示结束提示并隐藏签文与生成入口。
- 数据目录选择第 11 卦泰，显示上坤下乾、自下而上 111000。
- 纸签预览包含卦象、基础签和小行动，未放二维码。

## 尚未验证
未执行真实下载至手机相册、剪贴板拒绝路径、系统分享、打印对话框实际输出、实体打印机、扫码 TTL/竞争领取、后端幂等、模型内容质量。移动端实体 Safari/微信内置浏览器、320/390/430 全尺寸和减少动态效果设置也未实际逐项测试。CSS 包含适配不等于设备验收。

## 下一轮接续
先看 08 的问题并修改个性化内容，再由 B 提供真实接口与硬件参数。内容全量文化审核、Logo、前端生产安全和真机测试仍需继续；不能将“框架完成”标记为产品上线。

## 第二轮增量验收
首轮记录保留。第二轮针对性测试与浏览器检查见 [[11-第二轮确认与问卦历史规范]]；截图 tests/calendar-round2.png。新增本地持久化与日历、问卦交互模板、纸签缩短和网页扩展。真实 AI 仍未接入。
