zoetangprometheus-dotcom/cyber-turtle-clawhunt/archive/project-documents/A-前端与内容/整体框架-v0.1/12-前端剩余工作审查.md

---
date: 2026-10-31
date-basis: user-request
updated: 2026-10-31
type: review
language: zh-CN
tags: [review, cyber-turtle, frontend]
ai-first: true
---
# 前端剩余工作审查与纸签调整

## 给后续 Codex
用户要求放大纸签内六爻卦形、卦名和上下卦标签，并审查剩余前端工作。本次使用 review-frontend-production 技能的 quick / audit_plan：只实施指定比例调整，其他发现尚未修复。本报告是重点审查，不是全站逐组件验收或上线认证。

## 基线与范围
源码：本目录 h5/index.html、style.css、app.js、history.js、data.js；无运行依赖或后端。2026-10-31，检查源码和本机 HTTP 浏览器，390px 视口。数据为固定乾卦、四主题样例和问卦模板。

发现入口：一个主页面，导出、纸签、64 卦、历史日历四个弹窗，以及演示状态控制台。本轮重点检查纸签、记录保存、日历焦点及真实功能接入缺口；不宣称完整测遍所有弹窗/设备/异常。

## 本次已修改与验证
- h5/style.css：只放大主纸签和打印预览中的卦象身份区，不修改库内浏览图样、配色、字体家族或正文。
- 主纸签卦形宽 72→108 CSS px，爻线高 6→8 px；卦名 38→52 px；标签 11→13 px。
- 打印预览卦形改为 29mm 宽、独立 12mm 卦名及 3mm 标签；58mm 纸宽仍为试排假设。
- h5/app.js 的纸签预览渲染：原来“卦名与上下卦”一行文字拆成独立层级，与用户截图保持一致。
- `node --check h5/app.js` 通过；浏览器读取尺寸为 108px / 52px / 13px，390px 视口页面无横向溢出；纸签预览实际打开并截图。
- tests/paper-large.png 为本次证据。Canvas 分享卡版式未随本次纸签要求修改。

## 未实现的主要功能
| 优先顺序 | 事项 | 当前证据/状态 | 主责与完成条件 |
|---|---|---|---|
| 1 | 真扫码入口与记录加载 | app.js:6–7 创建本地 demo ID；没有读取二维码 token、发起领取请求或读取后端记录。输入不同二维码地址不能据此展示真实对应签 | A 接入，B 提供领取/恢复 API；两张真实纸签分别扫码，网页内容不串签 |
| 2 | 真正的 AI 主题解读与问卦 | app.js:21 为静态样例，23–26 为 650ms 延迟和模板文本；没有模型调用 | A 接口状态，B 执行模型；同卦绑定、超时/重试/失败可恢复，有真实请求和结果证据 |
| 3 | 实际会话、任务恢复与权限状态 | app.js:28–30 的到期/已领取/网络失败由下拉框切换；无服务端 TTL、竞争领取、轮询和恢复 | A/B；入口过期与已领取会话分开，刷新查询同任务，不能重复生成或读取别人记录 |
| 4 | 完整的 64 卦内容输入 | 64 卦结构数据存在，makeRecord 仍只取 examples.hexagram_fixture；不是 64 卦分别具备的中文释义系统 | A 内容核对、B 数据响应；每卦的名称/爻线/解释有来源，网页用对应记录渲染 |
| 5 | 问答的独立保存/分享 | app.js:40 的 blocks 只支持基础签和主题深解；问答能本地回看，但没有问答卡导出入口 | A，属于新增问卦体验的补全建议；选定一条问题及回答能导出，不混入其他问答 |
| 6 | 正式部署及设备联调 | 当前本机演示，无生产入口、真实屏幕或打印机链路 | B 部署/硬件，A 手机联调；稳定 HTTPS 域名、真机扫码、实际纸宽下试打 |

第 5 项是补全建议，用户尚未明确要求问答单独导出；不应误记为已承诺功能。系统原生分享也未实现，现有 PNG/复制方式已满足初版“至少一种保存方式”的设计，不必为了凑清单增加功能。

## 已确认的问题（后续三项均已修复，原始发现保留）
### F01 / P1 / 已解决：多页面保存同一签可能丢失问答
- 定位：h5/history.js:8，save 删除旧记录再放入调用方传入的整个快照；app.js:11 的 persist 不合并已有问答。
- 证据：使用真实 history.js 和内存 Storage 复现：A/B 同时读取一份记录；A 添加问题 A 保存，B 在旧快照添加问题 B 保存。最终读取 questions 只有 B，A 被覆盖。是代码级可复现结果，未伪称两个浏览器真机测试。
- 影响：手机重复扫描打开多个页签，或旧页签恢复操作，可能覆盖另一页新保存的解读/问答。
- 修复方向：以 reading_id 归组，按 question_id 合并问答、按主题合并成功结果，纸签快照保持不变；同时监听 storage 事件或刷新最新记录。跨标签同时写入还需序列化写入或事务存储方案，不能只靠一次读取后合并宣称彻底解决竞态。
- 验收：两个页面交错添加不同问题，刷新后两个问题都存在，旧纸签不被回写覆盖。

### F02 / P2 / 已解决：历史内容校验不完整，局部坏数据可能让页面初始化失败
- 定位：h5/history.js:6 与 app.js:14、17。
- 证据：真实 valid() 接受 questions:[{}]；renderQuestions 随后传入 undefined answer，appendSections 访问 content[key] 会抛错。源码与 validator 执行证明，未向用户浏览器写入坏数据。
- 影响：已有数据发生局部损坏/字段迁移不兼容时，顶层 JSON 合法但无法显示页面，现有读取失败提示不会兜住此情形。
- 修复方向：增加版本化的嵌套字段校验，隔离有问题的记录并保留原数据，页面仍可打开；不要直接清空整个历史。
- 验收：缺 answer、坏日期、错爻线等输入分别得到可理解提示；完整旧记录仍可回看。

### F03 / P2 / 已解决：日历选中日期后键盘焦点丢失
- 定位：h5/app.js:35，点击后 renderCalendar 重建所有日期按钮。
- 证据：浏览器点击第一天后，document.activeElement 为 BODY，ID 为空；原按钮被 replaceChildren 移除。
- 影响：键盘用户连续选日期需重新导航，焦点位置与视觉选择脱节。
- 修复方向：保留现有日期按钮或在更新后把焦点恢复到同一日期；月份切换保留合理焦点。
- 验收：使用 Tab/Enter 选择日期后焦点仍在选中日期，继续操作不回到页面开头。

## 已做但仍需实际验证
- 真正手机 Safari、微信内置浏览器的 localStorage 保留、隐私模式、图片下载/长按保存及权限拒绝。
- 320/390/430 多宽度长内容、键盘弹起、对话框滚动和减弱动态效果；本轮只对 390px 指定区域验证。
- 热敏打印机有效点宽、字体、黑线清晰度、换行和纸路；CSS 预览不等于真纸签。打印设置关闭背景时，基于 background 的爻线是否输出需实测或改用明确打印位图。
- 服务端任务幂等、会话过期、多人竞争、限流、模型输出校验，前端本身不能证明这些已成立。
- 历史记录导出备份/删除管理尚未设计。它们是后续产品决策，不将其作为本轮用户已要求的功能。
- Logo 定稿和全量文化文案审核仍为内容工作，不计作前端程序缺陷。

## 推荐先后顺序
1. 优先处理 F01 数据覆盖，再补 F02 容错和 F03 焦点；这些不依赖 B，可单独修复。
2. 与 B 冻结真实领取、记录加载、AI 问卦/深解接口，再替换演示逻辑；不要只删除演示标签。
3. 完成真实手机保存/历史与实体纸签验证；最后按用户决定精修 Logo、文案和需要的问答分享形式。

本轮只实施纸签比例修改。以上问题和待接入事项均仍开放。

## 修复回执
用户随后授权修复 F01/F02/F03，三项现已实现并通过针对性复验。具体机制、命令和证据见 [[13-三项前端修复验收]]。上述“未修复”描述仅指最初审查时点；真实扫码/AI/硬件等其他待办不因本回执完成。
