zoetangprometheus-dotcom/cyber-turtle-clawhunt/docs/receipt-layout-preview.png

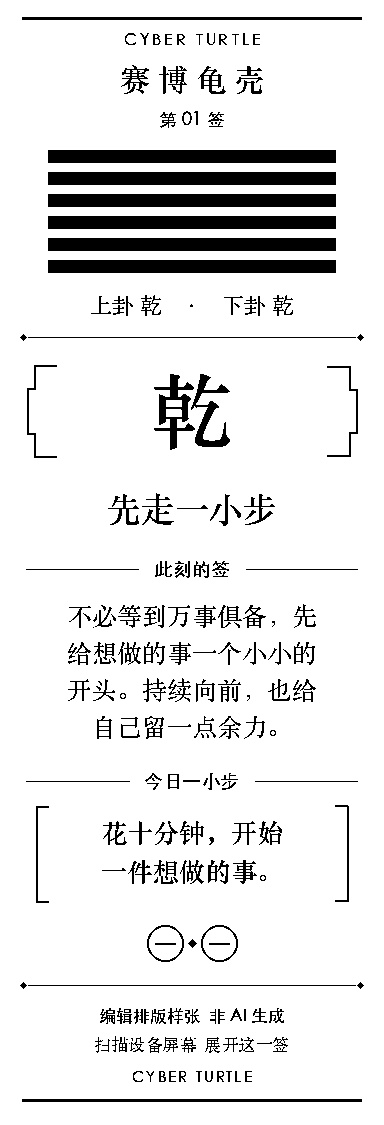
docs/receipt-layout-preview.png
