zoetangprometheus-dotcom/cyber-turtle-clawhunt/archive/project-documents/A-前端与内容/05-跨角色对接与验收清单.md

---
date: 2026-10-31
date-basis: user-request
updated: 2026-10-31
type: project
language: zh-CN
tags: [project, cyber-turtle, role-a]
ai-first: true
status: draft
---
# 跨角色对接与验收清单

> 2026-10-31 第二轮更新：用户已确认“古典外观＋温暖现代解读”，纸签缩短、网页扩展，增加同卦问卦输入、本机历史与日历。此项决定覆盖本文早期“不加自由提问/历史留待未来”的范围；实现与接口见 [[整体框架-v0.1/11-第二轮确认与问卦历史规范]]。

## 给后续 Codex
用户已明确自己承担 A 角色，并授权本项目产出保存在项目目录内。本文件依据 [[01Projects/Clawhunt 黑客松 - 赛博龟壳/赛博龟壳_产品定位_PRD_三人分工_v3.1]] 制作；新增细节是 AI 辅助工作稿，未经团队确认或真机验收，不覆盖 v3.1。
任务入口：[[01Projects/Clawhunt 黑客松 - 赛博龟壳/A-前端与内容/00-A角色任务与交付总表]]。截至 2026-10-31，未取得硬件参数、后端或比赛官方要求。

## 发给 B 的对接清单（草稿，未发送）
我负责 H5、纸签视觉和 AI 内容规范。请确认以下参数，便于冻结稿件与前端接口：
1. 屏幕分辨率/方向、可显示窗口尺寸；打印有效点宽/DPI、中文或位图打印方式。
2. 卦象由设备还是后端生成；统一卦 ID、上下卦编码及自下而上的六爻数组。
3. 领取接口、会话 Cookie/令牌方式、响应字段和错误码，能否提供同一签文的成功/过期/已领取样例。
4. 深解请求/查询接口、任务 ID、幂等及重试机制；建议同一签同主题优先返回已完成结果，是否采用请确认。
5. QR 激活及打印完成条件、180 秒入口和建议 30 分钟会话是否采用；共享设备开始新一签时如何撤销旧入口。
6. 模型、结构化输出支持、超时预算、备用内容标记；敏感凭据由 B 管理，不放前端。

## 发给 C 的对接清单（草稿，未发送）
请提供器物方向图或草图、中央窗口和出纸口位置、八卦纹路布局。A 会据此统一纸签、屏幕和 H5 视觉。外壳终稿需等 B 的模组尺寸和真实扫码结果；符号与光区映射由 A/B/C 共同确认。

## 提议给前端的最小数据契约
以 v3.1 路由为基础，不在本稿宣称接口已经实现。
| 数据 | 必需字段 |
|---|---|
| 已领取签文 | reading_id、hexagram_id、名称、上下卦、lines_bottom_to_top、base_reading、content_origin、session_expires_at |
| 深解任务 | task_id、theme、status（pending/running/succeeded/failed）、成功内容或 error_code |
| 会话错误 | invalid_token / expired / claimed / session_expired；映射 UI 文案 |

模型返回 06 中的文字对象，B 添加上述业务元数据。服务端用会话检查 reading_id 归属；客户端不接受修改卦象。线上字段名最终由 A/B 共同锁定，不能只依据本提案直接改另一人的实现。

原 PRD“设备认证密钥只在后端”的措辞还需 B 细化：模型 Key 仅服务端；设备怎样持有或获得自身认证凭据需要明确，不由 A 擅自设计。

## 联调用例（全部待执行）
| 编号 | 操作 | 验收结果 |
|---|---|---|
| A-Q01 | 扫真机新码 | 纸签、屏幕、网页同一卦象和基础内容 |
| A-Q02 | 只保存基础签 | 无需选主题或调用第二次模型；图片可读 |
| A-Q03 | 依次选四主题生成 | 主题相关、原卦不变，基础签不变 |
| A-Q04 | 连点生成、刷新、网络中断后重试 | 不产生并行重复任务；恢复已有任务 |
| A-Q05 | QR 到期前领取并停留至 QR 过期 | 独立网页会话继续有效 |
| A-Q06 | 两浏览器竞争领取 | 只有一个获得权限；同一浏览器刷新恢复 |
| A-Q07 | 第二人起卦 | 旧未领取入口撤销；第一人的已领取页面不串签 |
| A-Q08 | 模型缺字段/超长/超时 | 不打印不合格输出；明确备用或失败状态 |
| A-Q09 | 手机导出、拒绝分享、复制失败 | 反馈准确；有图片预览/文字回退 |
| A-Q10 | 320px、长文案、字体加载延迟 | 不溢出、不裁字、导出内容完整 |
| A-Q11 | 减少动态效果、键盘操作 | 页面仍完整可用，状态变化可理解 |
| A-Q12 | 会话到期后请求深解 | 服务端拒绝，UI 明确解释，不跳到他人记录 |

记录设备/浏览器、版本、操作、实际结果、截图或日志和缺陷。10 次整机求签与多手机扫码仍需 B/C 共同执行；本清单不是通过回执。

## Pitch 内容骨架 v0.1
1. 开场：“遇事不决，摇壳问问。” 描述小纠结、仪式与留存的产品设想。
2. 产品：一件可摇动的东方器物，通过上下卦灯光和真实纸签形成体验。
3. 演示：摇动 → 出签 → 屏幕码 → 主题深解 → 保存。素材分别标注真机实录或设计示意。
4. 用户：自用和赠礼两种场景是待验证假设；放真实访谈原话与样本数，不编购买意愿比例。
5. 商业：以实体销售为主；成本填真实 BOM，定价填测试方案，未测就标待验证。
6. 证据与后续：已完成的功能、失败记录与下一步；双龟/NFC/云收藏放未来，不混入本轮演示承诺。

比赛官方评审标准和提交格式尚未提供，以上不是主办方要求。需明确路演时长后再制作页数和逐页讲稿。

## 开源复用候选（2026-10-31 查阅，未下载或集成）
- [jesshewitt/i-ching](https://github.com/jesshewitt/i-ching/blob/main/README.md)：可参考字典结构和静态网页组织；README 区分 MIT 应用代码与 CC0 翻译数据，并注明翻译由 AI 生成、作者编辑。因此只作为候选数据来源，不能代替中文原典逐卦核对。它的三枚钱币起卦及变爻流程不直接移植到本项目。
- [pro-vi/iching](https://github.com/pro-vi/iching)：MIT 终端应用，可参考卦象展示；终端界面与本项目 H5 不匹配，不据此替换前端架构。具体内容文件的来源仍需查阅其 TEXT_SOURCES 后再使用。
- [bubkoo/html-to-image](https://github.com/bubkoo/html-to-image)：DOM 转图片候选；[package.json](https://github.com/bubkoo/html-to-image/blob/master/package.json) 标注 MIT。若选用，需实际测试中文字体、外部图片、长卡和目标手机；本轮没有安装依赖或宣称手机导出已可用。

文化原典核对尝试：中国哲学书电子化计划乾/坤页面本次请求返回 403，未读到正文，不能登记为已核对来源。全量文化内容审核继续待办。
