zoetangprometheus-dotcom/cyber-turtle-clawhunt/docs/PRINT_BRIDGE.md

# Mac 电脑打印中转

日期：2026-10-31。无需 USB Host 模块，复用已验证的 PyUSB 打印通道与现有 0.3.0 固件串口事件；不重新烧录，保留 Logo、摇动阈值与双卦时长。本轮通过既有 qrurl 命令把每次新签的二维码更新为认证领取入口，详见 [本机扫码服务](WEB_LOCAL_SETUP.md)。

已加入 [本机 AI 配置窗口](AI_LOCAL_SETUP.md)，DeepSeek Flash 真实调用通过；用户确认大有卦纸签出纸正常、手机内容一致。下文「演示票」仅指未启用 AI 的旧路径。串口读取与生成/打印分开执行，过时结果不打印，生成失败不自动改印演示票。

## 连接和使用

1. ESP32 USB-C → Mac；打印机 USB-B → Mac，可通过现有扩展坞。
2. 打印机使用原配 12V / 2.6A 电源，开关拨到 I 并装纸。GPIO 彩线不用连接打印机。
3. 新扫码链路先双击 `启动临时扫码服务.command`，确认服务健康及公网地址写入，再启动 `启动电脑打印中转.command`。看到 READY 后保留终端窗口。程序只处理启动后新产生的事件，不补印此前屏幕停留的卦。
4. 摇动设备，进入双卦同屏时创建本次 reading_id 和 token、发送 qrurl，收到 `QR_URL_SAVED` 后才生成短签并打印。更新失败/超时不生成或打印。屏幕仍按原定时间显示二维码，纸签不印二维码。
5. 双击 `停止电脑打印中转.command`，或在前台终端按 Ctrl+C 停止。重新烧录或使用其他串口工具前先停止中转。

Mac 必须保持开机、唤醒，两台设备保持连接。没有安装开机自启动服务。若拔线、USB 写入失败或程序报错退出，检查接线和出纸情况后重新启动；旧事件不会自动重印，重新摇动会产生新卦。不能把重新摇动称为重试原签。

未启用 AI 的旧演示票只显示卦象，不套用固定乾卦签文；启用 AI 后使用已固定的 title/message/action，并标注 AI 来源。网页读取同一份短签再延展长文。领取有效期、会话、历史与失败重试按 [WEB_LOCAL_SETUP.md](WEB_LOCAL_SETUP.md) 执行。

## 命令与依赖

依赖已安装在本项目 `.local/esp32/python`：pyserial、pyusb、libusb-package；无需全局驱动或修改系统默认打印机。其他协作者需先准备 Python 环境并安装依赖，参见 PRINTER_XP58IIH.md。

```sh
# 默认只模拟，不出纸
.local/esp32/python/bin/python scripts/print-bridge.py
# 开始监听并实际打印
.local/esp32/python/bin/python -u scripts/print-bridge.py --send
# 停止本项目的中转进程
.local/esp32/python/bin/python scripts/print-bridge.py --stop
# 定向测试，不访问硬件
python3 tests/print-bridge.test.py
```

串口默认仅在 CH343 设备唯一时自动选择；多设备时显式传 `--port`。`--trigger-once` 用串口启动一次真实起卦，仅供联调，正常启动不使用。重复启动会被项目锁阻止。

## 去重和错误边界

- 串口 EVENT 的编号、上下卦和六爻必须与 data/hexagrams.json 一致；仅在随后 STATE 3 时发送。回到首页或设备重启会清除待打印事件。
- `.local/esp32/print-bridge.sqlite3` 在写入 USB **之前**持久记录事件；同一事件切换页面、重复输入或程序重启均不自动重印。不要为了恢复打印而删除数据库。
- `usb_sent` 只代表 USB 已接受全部数据，不代表已检测到出纸。失败记为 `uncertain` 并停止，不自动重试可能已部分输出的票据；中途退出留下 `attempting` 也不会自动重印。缺纸、过热等可靠状态反馈仍待验证。
- 复用固件现有 `bringup-32位启动随机号-事件计数` 作为本地事件去重键；网页 Store 为新事件另建 reading_id 和一次性 token。设备事件编号不是认证凭据，重复事件不会重新发 QR 或改写短签。
- 当前固件并不等待电脑打印完成后才显示 QR，仍按原时序进入 QR。不能宣称已具备正式「确认打印完成后领取」闭环。

## 验证记录

- 本轮新增扫码服务：用户确认大有卦正常出纸且手机内容一致；主控验证网页短签一致、真实长解读/事业主题/问答及刷新回看。二维码更新 ACK 之后才生成/打印的代码已接入；打印完成检测和长期稳定性仍未验收。
- 一次短签 action 超限时未打印；提示目标收紧后讼卦真实复测通过，未截断原文或自动重试。失败后重新摇动会创建新事件，中转已重新载入等待新事件。

- 4 项定向测试通过：64 卦映射与编码、阴阳爻方向、阶段/跨重启去重、错误及复位不误打、部分写入失败不重试。
- 首轮第 40 卦及纯英文 CHECK 004 虽获 USB ACK，使用者反馈未走纸，因此首轮未通过。已暂停中转并排查，无系统排队任务。标准 SOFT_RESET 和 GET_PORT_STATUS 均超时；随后 RECOVERY TEST 005 获使用者确认正常打印。未查明失效/恢复原因，不宣称软件复位成功或故障已根治。
- 恢复后自动触发第 20 卦「觀」（上巽下坤），随后记录人手摇动事件第 45 卦「萃」（上兌下坤）和第 8 卦「比」（上坎下坤），均进入 STATE 3 并完成 USB 发送。使用者确认「本张和再次摇动均正常」，电脑中转与纸签同卦实物验收通过；不是长期稳定性或缺纸恢复验收。
- 重复启动被锁阻止；停止入口实测生效，重新启动未自动补印旧事件；zsh 启停入口语法与 git diff --check 通过。
- 本轮后台运行日志为 `.local/esp32/print-bridge.log`，数据库、锁和日志均被 Git 忽略。前台双击启动时日志显示在终端。

复用开源库：[pySerial](https://github.com/pyserial/pyserial)、[PyUSB](https://github.com/pyusb/pyusb)、[libusb-package](https://pypi.org/project/libusb-package/)。底层 USB 发送逻辑与已实物验证的 scripts/printer-usb.py 共用。

### USB 断线后的恢复（2026-11-01）

- 用户报告不出纸。日志显示中转在 ESP32 串口 `read failed: [Errno 6] Device not configured` 后退出，项目进程锁检查确认为 stopped；这是本次已确认的故障，尚不能据此排除打印机实物问题。
- 当前 XP-58IIH USB 枚举正常，接口 0、Bulk OUT 0x01 / IN 0x81；本机及公网 `/api/health` 均返回 200。直接发送 28 字节短测试票 `USB RECOVERY TEST 006` 获 USB ACK，用户确认「正常出纸，文字清楚」，当前 USB 直接打印实物通过。
- 已恢复中转，00:49 启动日志为 `READY mode=PRINT`；设备 0.4.0、IMU/触摸正常、QR 已配置。没有自动补印之前标记 usb_sent 的三张票，没有更改固件或摇动参数。用户重新摇动后确认「已自动出纸，卦象一致」，本次 USB 直接打印及新起卦自动打印的实物恢复验收通过。
- 当前中转仍采用断线后停止的行为；本次恢复不代表已实现 USB 自动重连，也不代表已经根治打印机收到 USB ACK 但不出纸的问题。
- 恢复后日志记录第 6 卦（上乾、下坎）完整阶段及 52,314 字节 USB 发送；用户实物确认如上。另在 00:55:29 观察到设备 BOOT，该次中转仍继续运行；重启原因未确定，本次成功不能扩展为长期串口/供电稳定性验收。

### 误触电源开关后的检查与错误处理修正（2026-11-01）

- 用户误触打印机电源开关后报告失联，随后确认已开机、指示灯常亮。USB 已重新识别，但旧中转有任务停在 attempting，后续仍接收 EVENT/QR 而未继续发送；之后又记录到 ESP32 串口断开，中转退出。
- 检查发现 `printer-usb.py` 在找不到设备、接口不符或没有 Bulk OUT 时抛出 SystemExit，会绕过 Bridge/worker 的 Exception 处理，使工作线程退出而未上报失败。已把三处操作性错误改为 RuntimeError；现有错误处理会记录 uncertain 并停止中转，不自动重印。此修正解决已证实的漏报路径，不据此断言现场所有停滞都由同一原因导致。
- 新增无真机回归：模拟打印机消失，调用实际 send_payload 经 Bridge.print_job，检查普通异常、任务 uncertain 和同事件不重复发送。主控独立复核，并与原部分写入失败用例一起运行，2 项通过。
- 直接发送 29 字节 `POWER SWITCH CHECK 007`，用户确认「正常出纸，文字清楚」。当前 USB 连接及短票实物通过；01:26 重启修正版中转为 READY mode=PRINT，等待新起卦，未补印中断的旧任务。
- 设备仍为 0.4.0，IMU/触摸正常、QR 已配置。灯光未启用，震动与摇动参数未修改。没有新增自动重连功能；误断电后应先恢复供电，再检查/重启中转。

### 图像发送中断后的完整断电恢复（2026-11-01）

- 03:39 的第 50 卦发送到 25,536 字节时中断，任务 `bringup-49af0e45-2` 标为 uncertain，中转按既定行为停止。检查时 USB 能枚举，不能据此认为可正常出纸。
- 用户确认纸卷/走纸，先仅拨电源开关重启后，25 字节 `USB LINK CHECK 008` 获 USB ACK，但用户确认仍没有出纸。暂停刚恢复的中转；macOS CUPS 没有待处理任务。
- 用户随后拔掉打印机 USB、关闭打印机电源约 10 秒，再开电源并接回 USB；ESP32 保持连接。29 字节 `USB RECONNECT TEST 009` 获 USB ACK，用户确认「正常出纸，文字清楚」。
- 这组对比说明完整断电重连后实际打印恢复；残留图像接收状态是排查假设，未证明最初传输中断的根因，也不宣称仅拨电源开关一定会保留状态。
- 短票确认后恢复中转，等待新事件。旧 uncertain 任务保留、不自动补印，没有改动固件、AI 配置或发送参数。以后若出现图像发送中断且短票获 ACK 却不出纸，先暂停中转，按上述完整断电顺序恢复，经短票确认后再启动中转。

### 新起卦仍未打印的继续定位（2026-11-01）

- 用户反馈晃动仍不能打印。03:56 最新事件已完成起卦、QR 更新和短签生成，随后 sender 异常；日志没有 USB 描述符，数据库为 uncertain。此故障位于 USB 设备发现/打开/读取配置阶段的可能性较高，不是仅凭现象就认定摇动灵敏度有问题。
- 原 Bridge 只打印通用停止信息，未保存 sender 原始异常；已将异常类型和原因保存到 jobs.error 并输出到日志。旧失败记录的具体原因无法由此补回。
- 复核已安装 PyUSB 源码后，删除先显式 release_interface、再 dispose_resources 的重复释放：前者在断开后抛错会跳过 dispose 并遮盖原异常。现在统一由 dispose_resources 释放接口和关闭句柄。未更换依赖、未清空全局 backend、未添加盲目重试。
- 独立复核并执行 3 项窄测试通过：缺打印机错误保存且不重试、部分传输错误保存且不重试、断开后的资源清理不遮盖原发送错误；git diff --check 通过。
- 用与中转相同的主线程 probe、后台线程发送方式生成「连接测试010」完整乾卦排版样张，明确标注非 AI 生成，不重印旧任务、不调用模型。52,314 字节全部获 USB ACK，线程正常结束；结果保存于忽略目录 .local/esp32/printer-worker-check-010.json。用户随后确认「完整出纸，内容清晰」，该后台线程长签样张实物通过。
- 新进程 probe 与 macOS IORegistry 均能看到当前打印机。PyUSB backend/context 在进程内复用，但每次 find 仍重新枚举；目前证据不能把故障归因于旧 Device 缓存或 macOS 线程机制。修正版中转于 04:06 恢复为 READY mode=PRINT，设备 0.4.0、IMU/触摸正常、QR 已配置。
- 04:08:39 收到真实 source=shake，第 38 卦（上离、下兑）依次进入 STATE 1/2/3/4，04:08:49 完成 52,314 字节 USB 发送。用户确认「自动完整出纸，卦象一致」，主控随后检查中转仍在运行。完整长签样张和真实摇动自动打印均已实物通过，本轮恢复验收完成；不扩展为长期稳定性或断电自动重连验收。

### 屏幕旋转后的连接联调（2026-11-01 10:39）

- 开始检查时仅 ESP32 可枚举，旧中转已在 04:51 的串口断开后停止；用户确认打印机供电并重新插好 USB 后，XP-58IIH 接口 0、Bulk OUT 0x01 / IN 0x81 恢复识别。
- 实际设备为 0.4.1-bringup，IMU、触摸正常，沿用已验收的 balanced_v4 摇动参数、180° 屏幕方向与震动配置。本次没有修改或重烧固件。
- 旧公网隧道失效，关闭已核实属于本项目的旧隧道后重建；当前地址见 WEB_LOCAL_SETUP.md。公网健康及三个 JS/CSS 资源检查通过。
- 10:39:31 启动中转并用 --trigger-once 发起一次明确的联调新事件 bringup-8611581a-1，第 56 卦「旅」（上离、下艮）；完成阶段切换、二维码更新 ACK、AI 短签生成，10:39:41 全部 52,314 字节获 USB ACK，jobs.status=usb_sent、error 为空。中转进程锁仍持有，等待后续摇动。
- 实物出纸、手机扫码及再次摇动自动打印待用户现场确认；USB ACK 不作为实物出纸证明。结果同步保存于忽略目录 .local/esp32/connection-check-20261101-runtime.json。

### 再次断线后的联调（2026-11-01 11:34）

- 用户要求重新调试。检查时两台设备可枚举，但旧中转在 10:58 之后发生串口 read failed / Device not configured 并退出；断开的物理原因未确定。设备报告 0.4.1-bringup，IMU/触摸正常，balanced_v4、180° 屏幕、震动启用与灯光禁用保持。
- 发送 33 字节短票 LINK CHECK 011，用户确认「正常出纸，文字清楚」，USB 直接打印实物通过。
- 旧扫码通道失效；首次重建虽注册 QUIC 连接，新域名却无法解析，启动器超时关闭通道并恢复原配置。保存日志后第二次重建成功；当前地址见 WEB_LOCAL_SETUP.md。本机及公网健康通过，app.js、live.js、style.css 均 HTTP 200 且与本地源码一致。
- 11:34:07 恢复中转并主动起卦一次，新事件 bringup-ea9f4372-1 为第 60 卦「节」（上坎、下兑）。完整阶段、二维码 ACK、AI 短签与 USB 发送通过，11:34:17 全部 52,314 字节获 ACK。
- 用户确认「本张和再次摇动都正常」。11:36:06 日志另收到真实 source=shake 新事件 bringup-ea9f4372-2，第 31 卦「咸」（上兑、下艮）；后续完成结果见本地验收 JSON。
- 本次恢复原有服务，未重印旧事件、未重烧固件、未改变摇动参数或 AI 密钥。中转仍采用断线后停止机制；没有新增自动重连或证明长期稳定性。验收保存于 .local/esp32/connection-recheck-20261101-runtime.json。
