zoetangprometheus-dotcom/cyber-turtle-clawhunt/(commit log)

2026-10-31 Initial frontend demo and backend collaboration guide
    [64卦核对表.csv]
2026-11-01 Archive complete Cyber Turtle prototype and project documents
    [64卦核对表.csv]
